blxlrsmb/3D-Display/README.md

A rotating circuit as a 3D display.

See video demo on [youku](http://v.youku.com/v_show/id_XNTY5OTkxNjY0.html?from=y1.7-1.2)
or [download video from this repo](https://github.com/blxlrsmb/3D-Display/raw/master/pres/img/blxlrsmb.mp4)

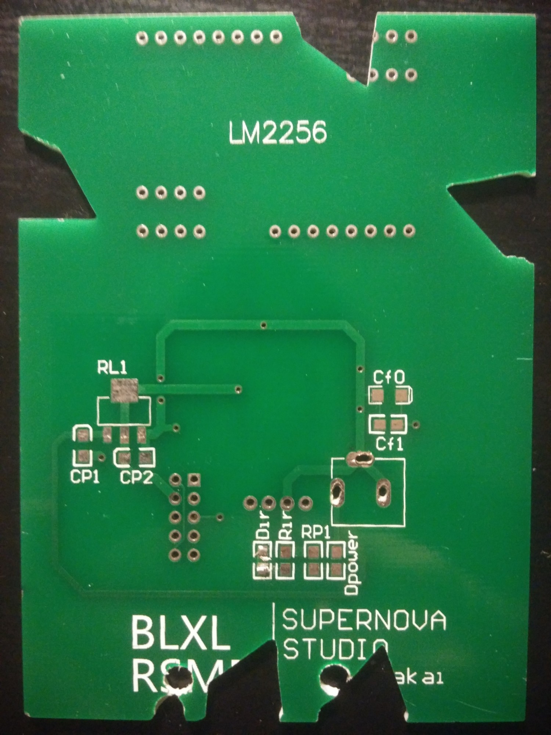
[picture p1: circuit.jpg]
