blxlrsmb/3D-Display/report/report.tex

% $File: report.tex
% $Date: Sat Jun 15 10:10:33 2013 +0800
% $Author: jiakai <jia.kai66@gmail.com>

\documentclass[a4paper]{article}
\usepackage{amsmath,amssymb,amsthm,fontspec,zhspacing,
graphicx,dirtree}
\usepackage[left=3cm,top=2.5cm,right=3cm]{geometry}
\usepackage[hyperfootnotes=false,colorlinks,linkcolor=black,anchorcolor=black,citecolor=black]{hyperref}

\zhspacing

\begin{document}
\begin{center}
	{\Large \bf 彩灯实验报告--BLXLRSMB设计及实现} \\
	\vspace{1.5em}
	计14 ~ 贾\hspace{1em}开 ~ 2011011275 \\
	计14 ~ 吴育昕 ~ 2011011271
\end{center}

\tableofcontents

\input{principle}
\input{design}
\input{usage}
\input{ack}

\end{document}

% vim: filetype=tex foldmethod=marker foldmarker=f{{{,f}}}
