blxlrsmb/3D-Display/report/ack.tex

% $File: ack.tex
% $Date: Sat Jun 15 10:10:00 2013 +0800
% $Author: jiakai <jia.kai66@gmail.com>

\section{致谢}
在本作品制作过程中，
感谢李山山老师在电路设计前期提供的指导帮助以及提供的接口元件，
感谢清华-伟创力SMT实验室老师提供的焊接技术支持以及免费提供的电阻元件，
感谢创新实验室老师提供的电路板机加工相关指导。

% vim: filetype=tex foldmethod=marker foldmarker=f{{{,f}}}
