blxlrsmb/3D-Display/pres/img/ball.jpg

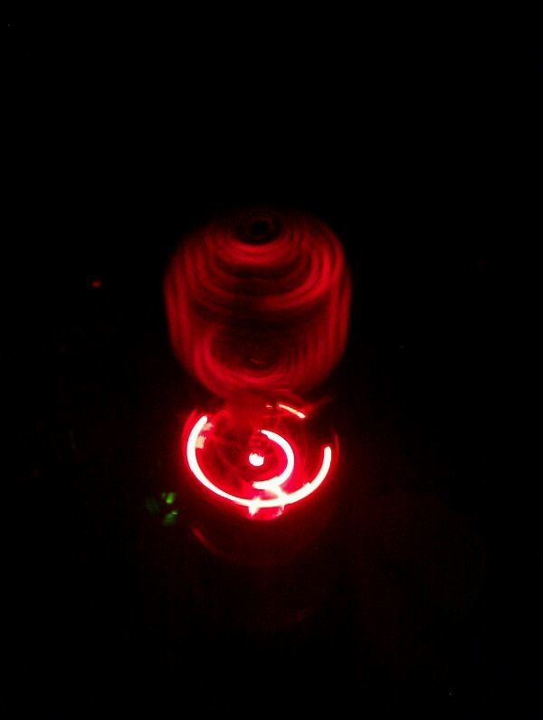
pres/img/ball.jpg
