blxlrsmb/3D-Display/pres/img/board.jpg

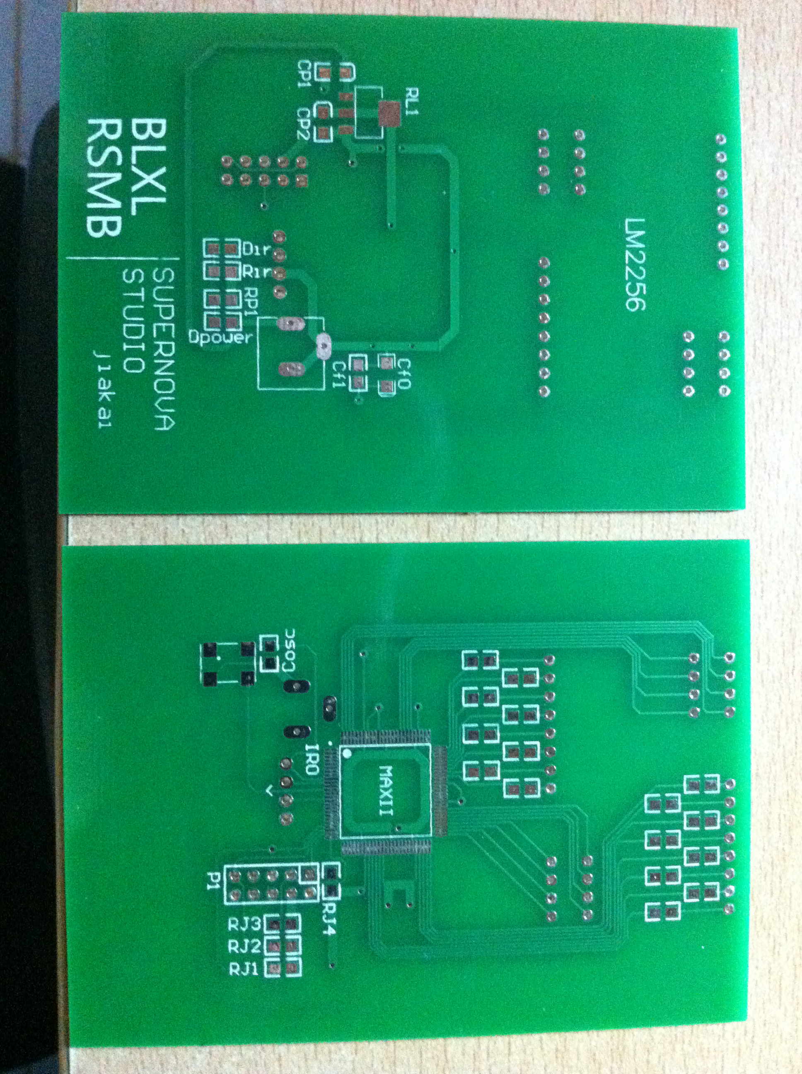
pres/img/board.jpg
