blxlrsmb/3D-Display/pres/img/board_shape0.jpg

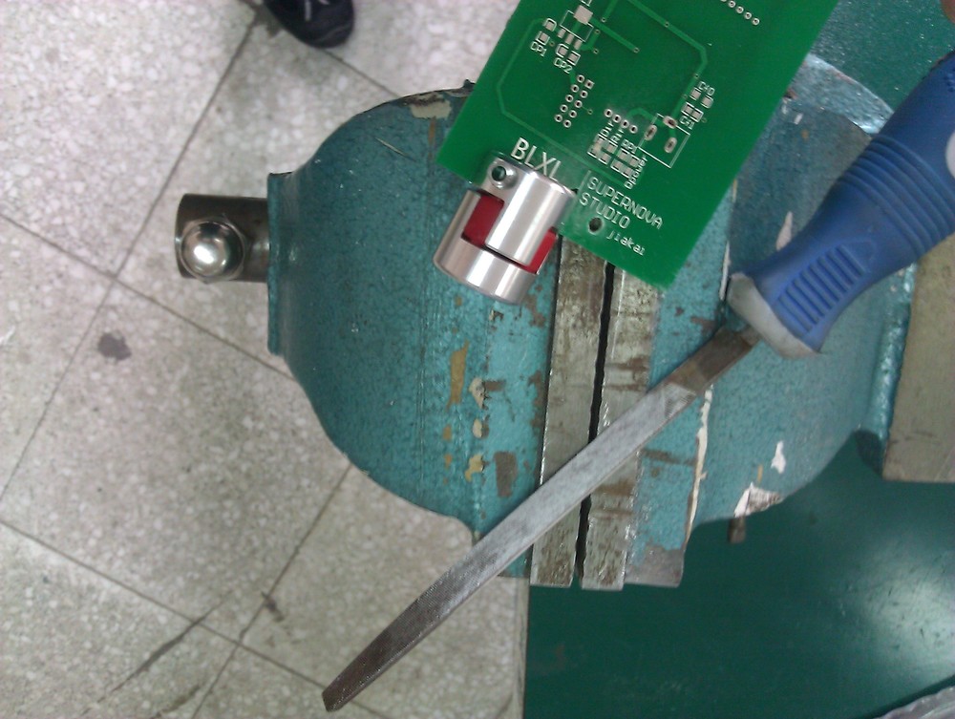
pres/img/board_shape0.jpg
