blxlrsmb/3D-Display/pres/img/board_shape.jpg

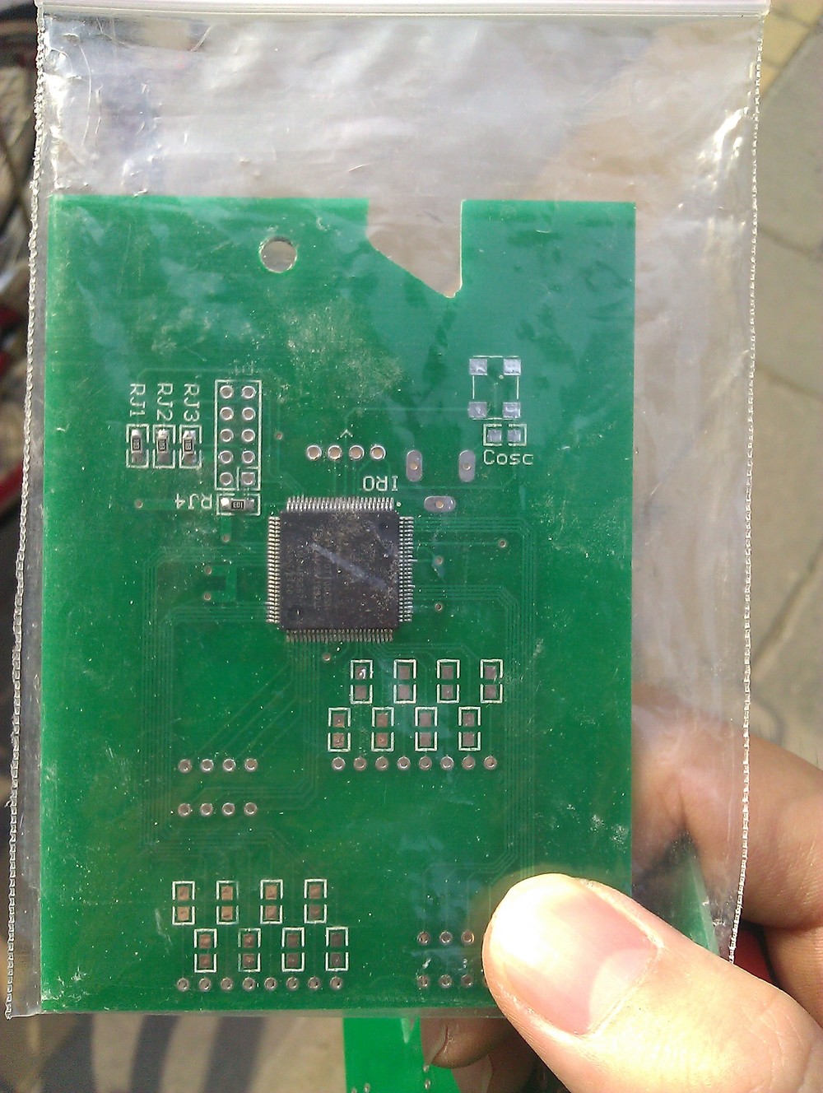
pres/img/board_shape.jpg
