blxlrsmb/3D-Display/pres/img/bzmh.png

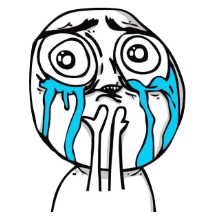
pres/img/bzmh.png
