blxlrsmb/3D-Display/pres/img/design.jpg

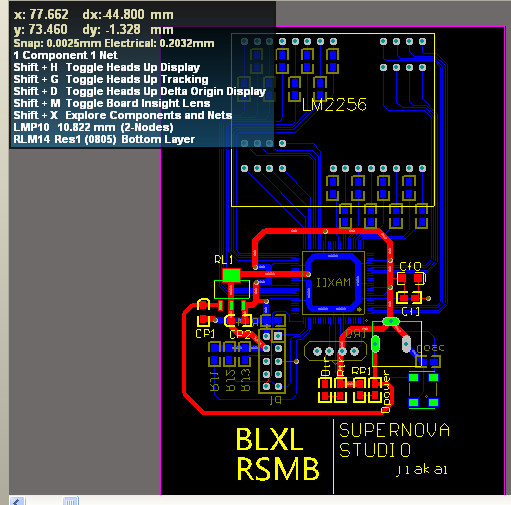
pres/img/design.jpg
