blxlrsmb/3D-Display/pres/img/desk.jpg

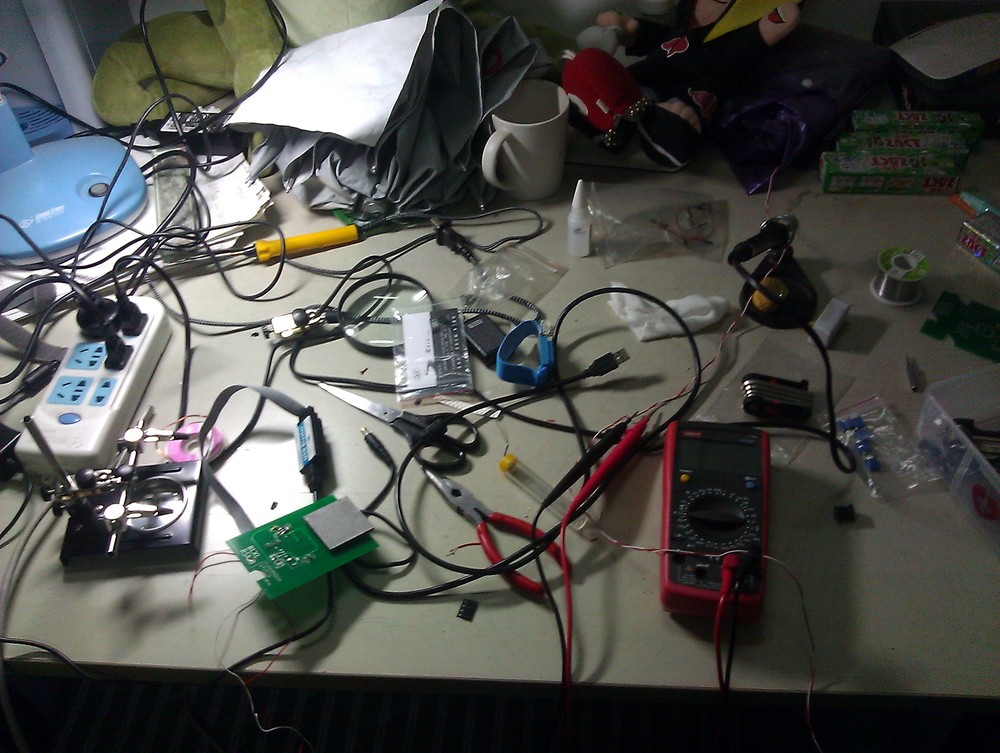
pres/img/desk.jpg
