blxlrsmb/3D-Display/pres/img/dong.jpg

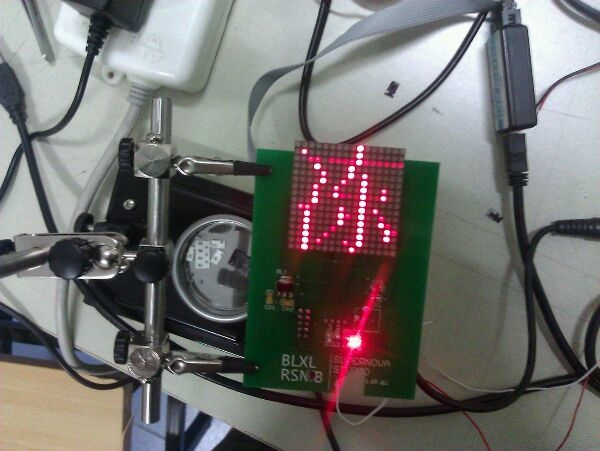
pres/img/dong.jpg
