blxlrsmb/3D-Display/pres/img/IMG_20130531_165948.jpg

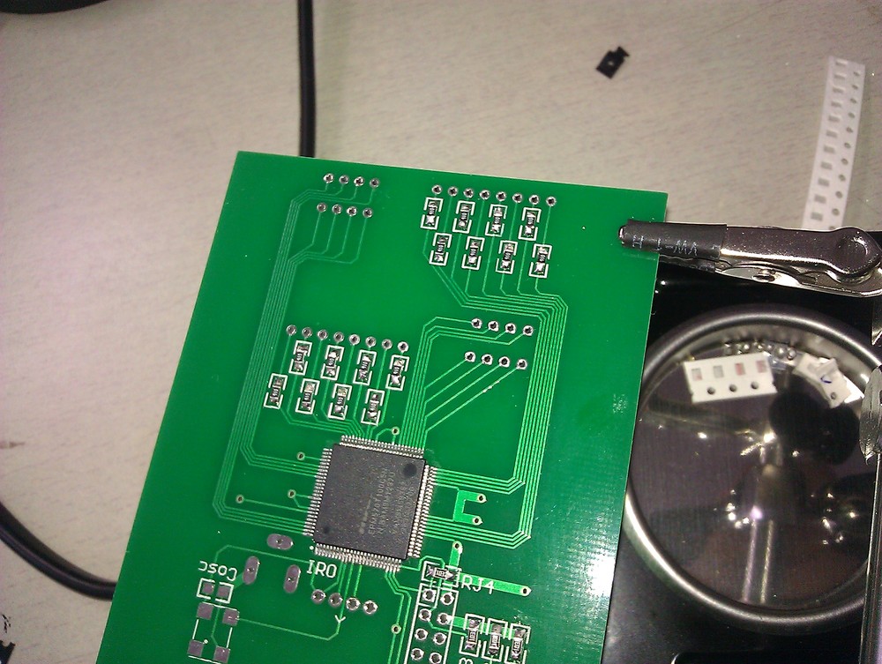
pres/img/IMG_20130531_165948.jpg
