blxlrsmb/3D-Display/pres/img/light.jpg

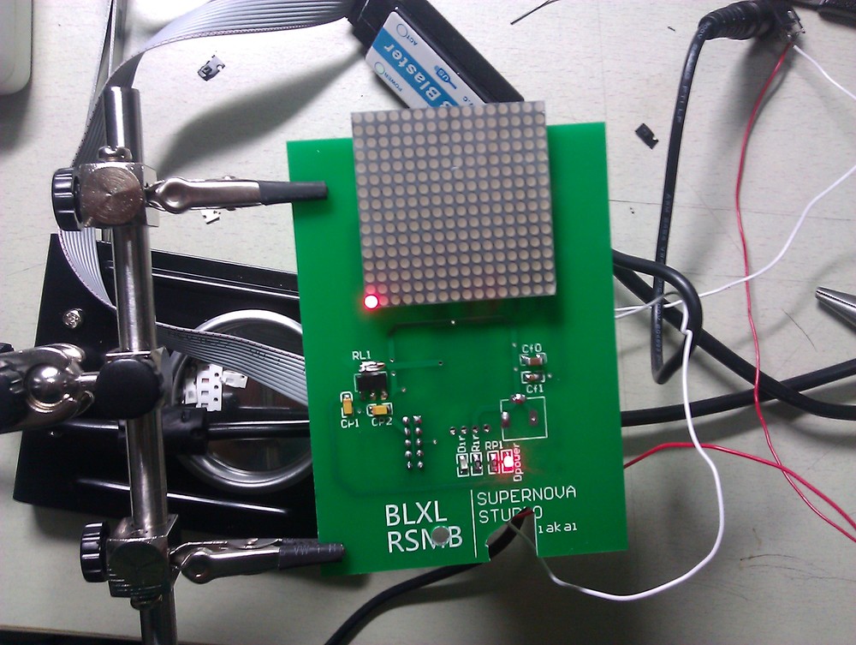
pres/img/light.jpg
