blxlrsmb/3D-Display/pres/img/station.jpg

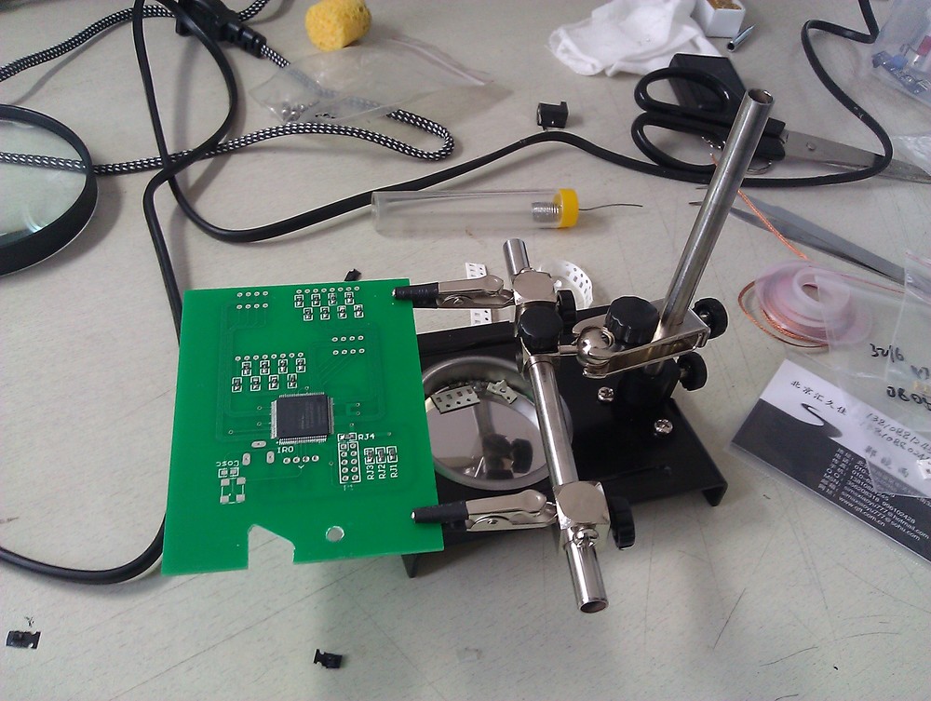
pres/img/station.jpg
