blxlrsmb/3D-Display/pres/cost.ods

名称 | 单价 | 数量 | 小计
EPM570T100C5N | 30 | 1 | 30
锂电池 | 13 | 2 | 26
锂电池充电器 | 10 | 1 | 10
SZ420788K(8*8点阵) | 4 | 4 | 16
电源线 | 5 | 1 | 5
漆包线0.5mm * 6m | 10 | 1 | 10
拨码开关 | 1 | 6 | 6
芯片焊接 | 20 | 1 | 20
0.3锡丝 | 33 | 1 | 33
100欧电位器 | 1 | 5 | 5
LM2256点阵 | 15 | 2 | 30
16M晶振 | 3 | 2 | 6
电动机+12v/2A电源 | 173 | 1 | 173
PCB制板(加急) | 400 | 1 | 400
无线供电模块(实验失败) | 46 | 1 | 46
尖嘴钳 | 18 | 1 | 18
焊接放大镜架 | 30 | 1 | 30
海绵 | 2 | 1 | 2
剪线钳 | 8 | 1 | 8
手持发光放大镜 | 15 | 1 | 15
合计 |  |  | 889
