blxlrsmb/3D-Display/(list of files, drawings)

Other design files:
circuit/circuit.SchDoc
circuit/design.PrjPcb
circuit/epm240.PCBLIB
circuit/ledmat.SchDoc
circuit/mylib.SchLib
