blxlrsmb/3D-Display/(commit log)

2013-06-11 backup for failed attempt to use 256-bit internal wire
    [anim.v, frame_reader.v, main.v]
2013-06-11 switch frame seem to work
2013-06-12 gen frame
2013-06-14 dir refactor & report
    [circuit.SchDoc, design.PrjPcb, epm240.PCBLIB, ledmat.SchDoc, mylib.SchLib]
